Satya968/MoodSense/hardware/circuit_diagram.png

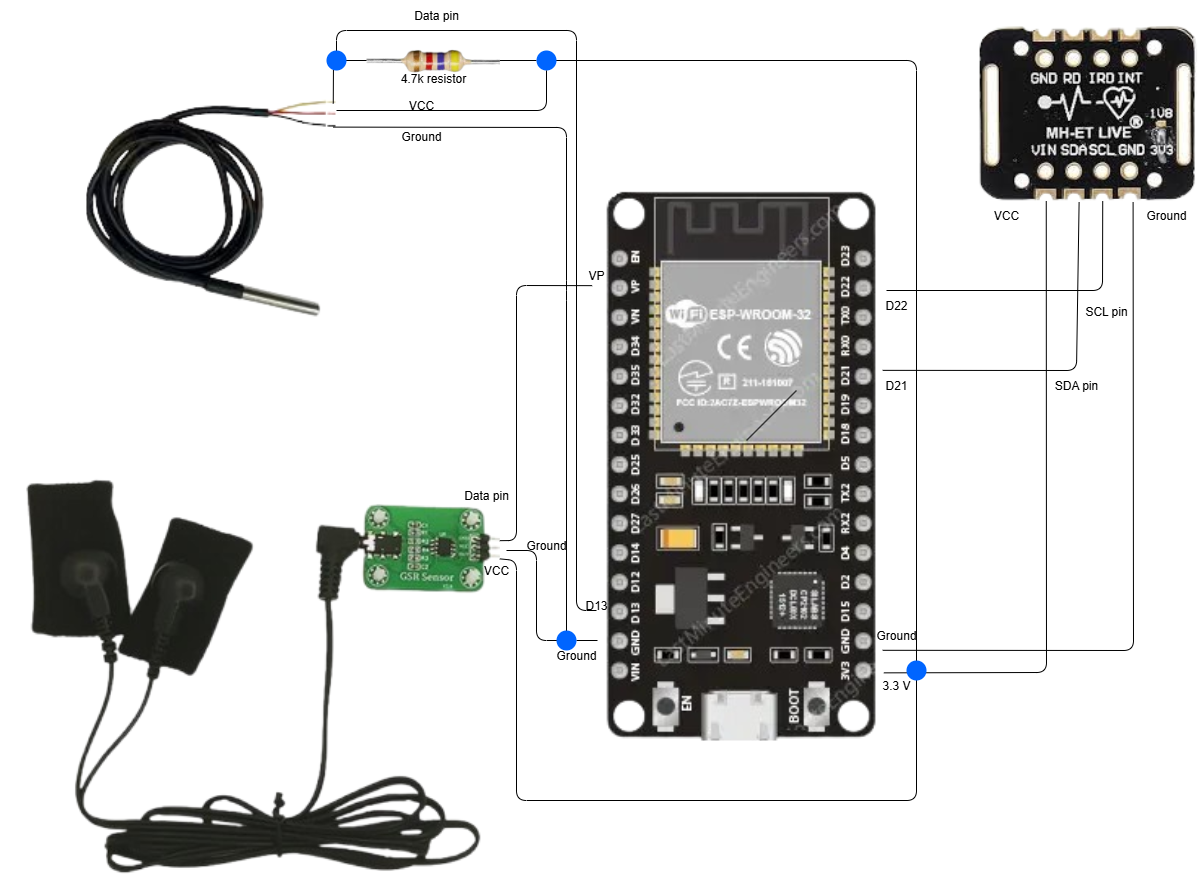
hardware/circuit_diagram.png
