Satya968/MoodSense/hardware/components_list.md

# Bill of Materials (BOM)

| S.No | Part Number | Component Description | Specifications | Qty | Unit Cost (₹) | Total Cost (₹) |
|---|---|---|---|-----|---|---|
| 1 | DS18B20 | Digital Temperature Sensor | 1-Wire, -55°C to +125°C, Waterproof | 1 | 65.00 | 65.00 |
| 2 | MAX30102 | Heart Rate & SpO2 Sensor | I2C Interface, 3.3V, Red/IR LEDs | 1 | 170.00 | 170.00 |
| 3 | GSR-002 | GSR Module v2 | Analog Output, 3.3V/5V Compatible | 1 | 650.00 | 650.00 |
| 4 | ESP32-WROOM-32 | WiFi + Bluetooth MCU | Dual-core, 240MHz, 4MB Flash, 520KB RAM | 1 | 700.00 | 700.00 |
| 5 | LM2596 | DC-DC Buck Converter | 3A(max), 3V-40V Input, 1.5V-35V Output | 1 | 50.00 | 50.00 |
| 6 | BH-18650-1 | 18650 Battery Holder | Single Cell, Wire Leads | 1 | 20.00 | 20.00 |
| 7 | IMR18650-20R | IMR 18650 | 3.7V, 2000mAh, 7.4Wh | 1 | 50.00 | 50.00 |
| 8 | JW-MF-FF-40 | Jumper Wires | Male to Female and Female to Female, 40pcs, 20cm | 2 | 45.00 | 90.00 |
| 9 | CABLE-USB-MC-1M | USB Cable | Micro USB to USB-A, 1m Length | 1 | 50.00 | 50.00 |
| 10 | TP4056-TC | Battery Charging Module | Li-ion Charger, USB Type-C, 1A Current | 1 | 30.00 | 30.00 |
| 11 | TEMP-GUN-IR | Temp Gun | -50°C to +550°C, ±1.5°C Accuracy | 1 | 753.00 | 753.00 |

**Total Project Cost: ₹2,628.00**
