Satya968/MoodSense/test_logs/sensorData_and_power_log_12hrs.csv

Timestamp(sec) | HeartRate(bpm) | Temperature (°C) | GSR | Detected mood | Actual mood | power usage(W)
30 | 71 | 34.13 | 1619 |  |  | 4.224
60 | 68 | 34.13 | 1644 |  |  | 4.224
90 | 64 | 34.13 | 1588 |  |  | 4.224
120 | 85 | 34.19 | 1712 |  |  | 4.224
150 | 89 | 34.19 | 1611 |  |  | 4.224
180 | 97 | 34.19 | 1642 |  |  | 4.224
210 | 88 | 34.25 | 1599 |  |  | 4.224
240 | 86 | 34.19 | 1650 |  |  | 4.224
270 | 75 | 34.25 | 1598 |  |  | 4.224
300 | 68 | 34.25 | 1598 |  |  | 4.224
330 | 74 | 34.25 | 1594 |  |  | 4.224
360 | 78 | 34.31 | 1584 |  |  | 4.224
390 | 89 | 34.31 | 1587 |  |  | 4.224
420 | 87 | 34.31 | 1558 |  |  | 4.224
450 | 88 | 34.31 | 1591 |  |  | 4.224
480 | 83 | 34.31 | 1535 |  |  | 4.224
510 | 77 | 34.31 | 1595 |  |  | 4.224
540 | 79 | 34.31 | 1523 |  |  | 4.224
570 | 78 | 34.31 | 1561 |  |  | 4.224
600 | 80 | 34.31 | 1505 |  |  | 4.224
630 | 76 | 34.25 | 1575 |  |  | 4.224
660 | 80 | 34.31 | 1518 |  |  | 4.224
690 | 91 | 34.31 | 1524 |  |  | 4.224
720 | 93 | 34.31 | 1499 |  |  | 4.224
750 | 102 | 34.31 | 1535 |  |  | 4.224
780 | 90 | 34.31 | 1491 |  |  | 4.224
810 | 96 | 34.31 | 1490 |  |  | 4.224
840 | 99 | 34.38 | 1466 |  |  | 4.224
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
