Satya968/MoodSense/test_logs/sensors_accuracy_1hr.csv

timestamp | Sensor data(MAX30102) | Reference data(Pulse Oximeter) | Sensor data(DS18B20) | Reference data(IR Temperature Gun)
30 | 90 | 85 | 31.87 | 32
60 | 86 | 80 | 31.87 | 32
91 | 80 | 76 | 31.87 | 32.1
121 | 88 | 74 | 32 | 32.2
151 | 86 | 80 | 32 | 32.1
180 | 83 | 77 | 32.13 | 32.3
210 | 85 | 79 | 32.13 | 32.2
240 | 93 | 76 | 32.19 | 32.2
271 | 77 | 76 | 32.25 | 32.2
301 | 97 | 79 | 32.25 | 32.3
331 | 88 | 79 | 32.31 | 32.2
360 | 83 | 79 | 32.31 | 32.4
390 | 80 | 81 | 32.31 | 32.3
420 | 87 | 78 | 32.31 | 32.4
451 | 97 | 84 | 32.25 | 32.2
481 | 84 | 73 | 32.31 | 32.3
511 | 86 | 84 | 32.31 | 32.4
540 | 94 | 79 | 32.38 | 32.4
570 | 87 | 88 | 32.31 | 32.4
600 | 88 | 88 | 32.25 | 32.2
630 | 89 | 82 | 32.56 | 32.3
660 | 91 | 87 | 32.19 | 32.1
690 | 86 | 89 | 32.44 | 32.7
720 | 82 | 85 | 32.38 | 32.1
750 | 88 | 84 | 32.12 | 32.4
780 | 94 | 87 | 32.69 | 32.3
810 | 79 | 82 | 31.94 | 32.5
840 | 90 | 85 | 32.81 | 32.1
870 | 85 | 88 | 32.06 | 32.8
900 | 87 | 91 | 32.37 | 32.4
930 | 92 | 86 | 32.75 | 32.1
960 | 84 | 87 | 32.18 | 32.6
990 | 88 | 85 | 32.49 | 32.3
1020 | 91 | 89 | 32.83 | 32.5
1050 | 86 | 83 | 32.11 | 32.2
1080 | 89 | 87 | 32.56 | 32.7
1110 | 83 | 86 | 32.29 | 32.1
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
