Satya968/MoodSense/test_logs/sensors_drift_15hrs.csv

Timestamp(sec) | HeartRate(bpm) | Temperature(°C) | GSR
30 | 0 | 31.19 | 155
60 | 0 | 31.19 | 144
90 | 83 | 31.25 | 144
120 | 76 | 31.25 | 147
150 | 74 | 31.25 | 173
180 | 74 | 31.31 | 167
210 | 71 | 31.31 | 170
240 | 86 | 31.31 | 166
270 | 92 | 31.31 | 174
300 | 95 | 31.31 | 178
330 | 88 | 31.31 | 174
360 | 83 | 31.31 | 171
390 | 82 | 31.31 | 176
420 | 78 | 31.31 | 175
450 | 73 | 31.31 | 195
480 | 68 | 31.31 | 192
510 | 59 | 31.37 | 180
540 | 65 | 31.31 | 177
570 | 71 | 31.37 | 186
600 | 83 | 31.37 | 185
630 | 78 | 31.37 | 176
660 | 74 | 31.37 | 176
690 | 76 | 31.37 | 175
720 | 79 | 31.37 | 171
750 | 78 | 31.37 | 173
780 | 74 | 31.37 | 175
810 | 65 | 31.37 | 170
840 | 62 | 31.37 | 167
870 | 69 | 31.37 | 161
900 | 74 | 31.44 | 155
930 | 78 | 31.37 | 148
960 | 79 | 31.44 | 148
990 | 73 | 31.44 | 144
1020 | 65 | 31.44 | 138
1050 | 61 | 31.44 | 133
1080 | 59 | 31.37 | 130
1110 | 51 | 31.44 | 126
1140 | 52 | 31.44 | 128
1170 | 52 | 31.44 | 121
1200 | 63 | 31.44 | 121
1230 | 76 | 31.5 | 122
1260 | 76 | 31.44 | 118
1290 | 81 | 31.44 | 112
1320 | 82 | 31.44 | 110
1350 | 78 | 31.44 | 102
1380 | 79 | 31.44 | 107
1410 | 79 | 31.44 | 100
1440 | 77 | 31.44 | 101
1470 | 77 | 31.44 | 103
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
