Satya968/MoodSense/test_logs/process_photos/mood_and_powe_logging_2.jpeg

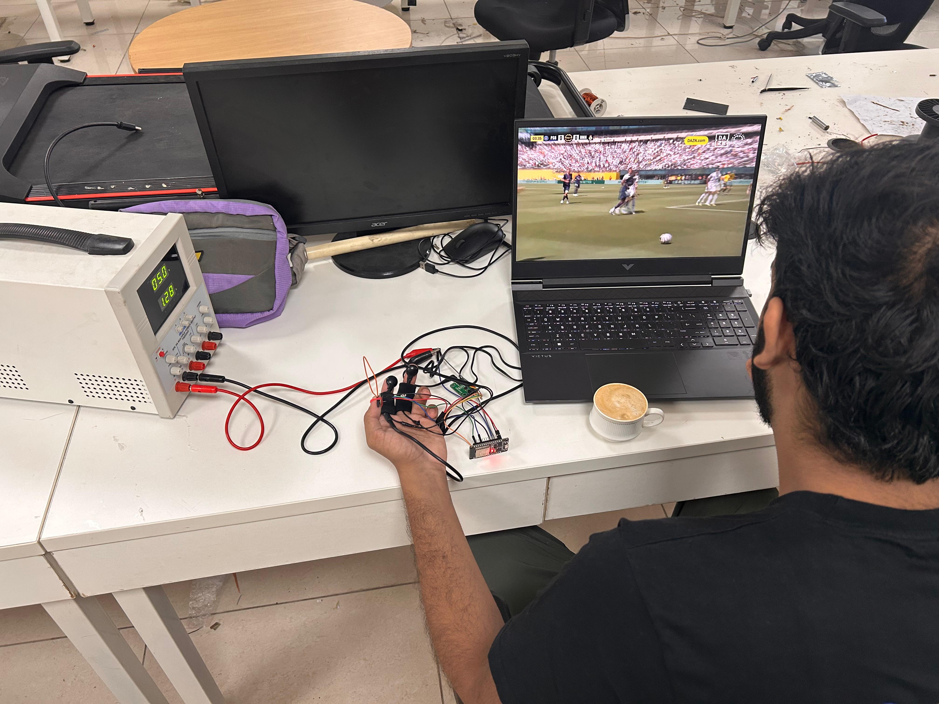
test_logs/process_photos/mood_and_powe_logging_2.jpeg
