Satya968/MoodSense/test_logs/process_photos/mood_and_power_logging_1.jpeg

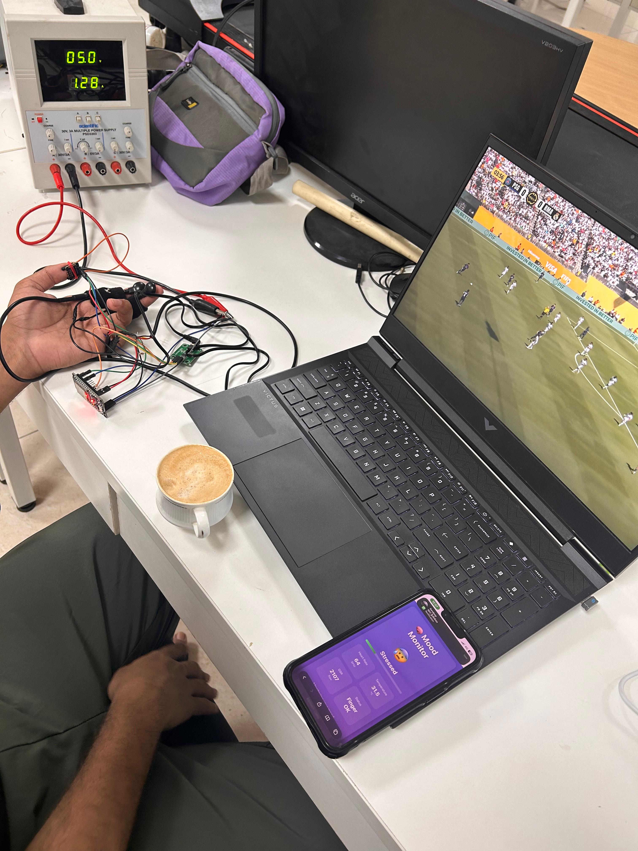
test_logs/process_photos/mood_and_power_logging_1.jpeg
