Satya968/MoodSense/test_logs/process_photos/sensors_accuracy_and_drift_1.jpeg

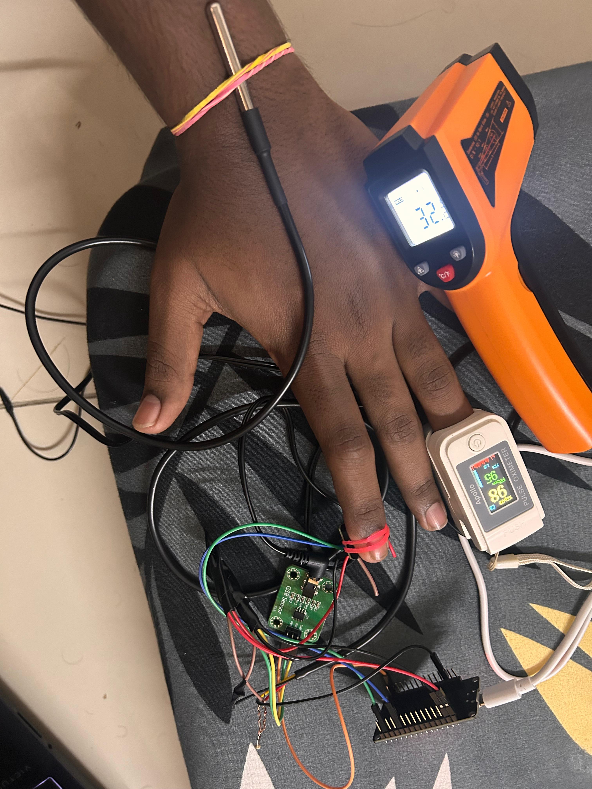
test_logs/process_photos/sensors_accuracy_and_drift_1.jpeg
