Satya968/MoodSense/test_logs/process_photos/sensors_accuracy_and_drift_2.jpeg

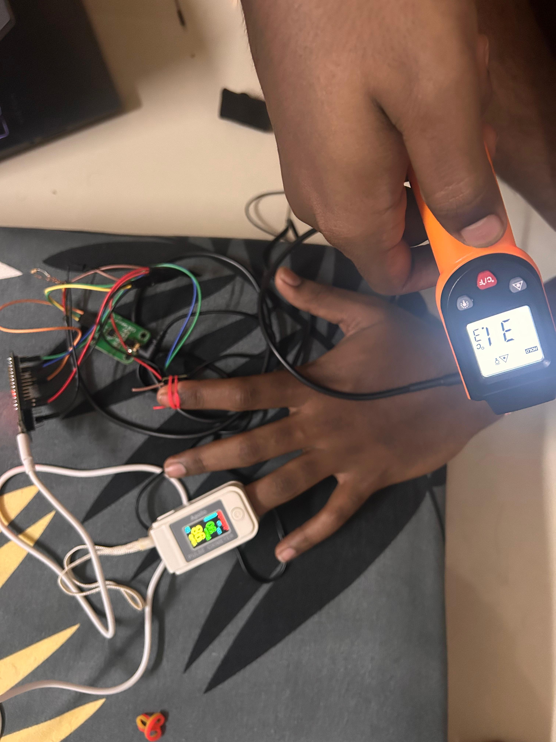
test_logs/process_photos/sensors_accuracy_and_drift_2.jpeg
